kinsamanka/picnc/hardware/PICnc_Breadboard.png

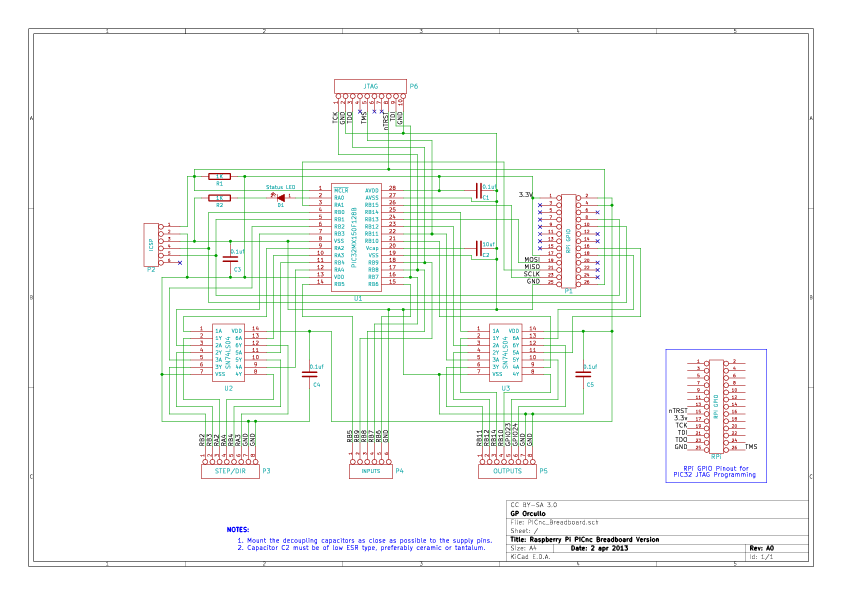
hardware/PICnc_Breadboard.png
