kinsamanka/picnc/hardware/PICnc_Jr.png

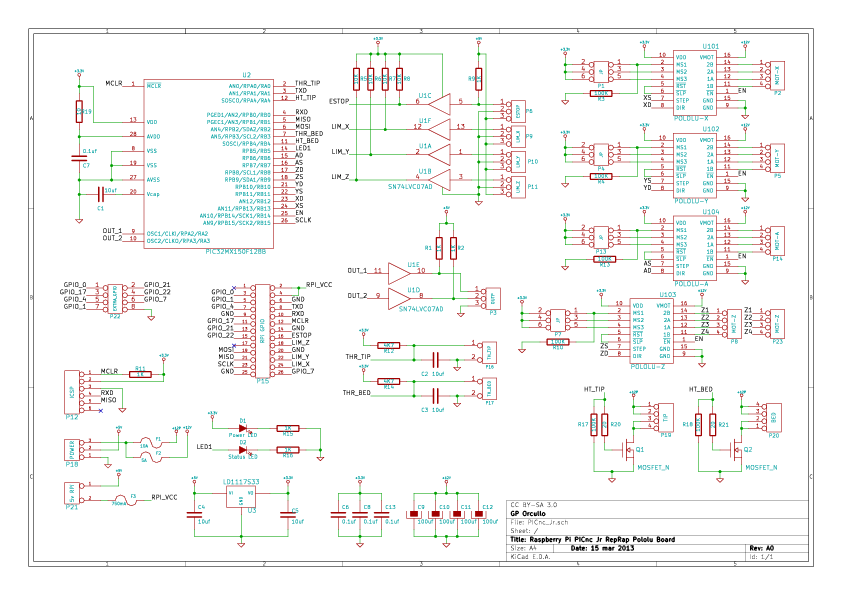
hardware/PICnc_Jr.png
