kinsamanka/picnc/hardware/PICnc_Jr_board.png

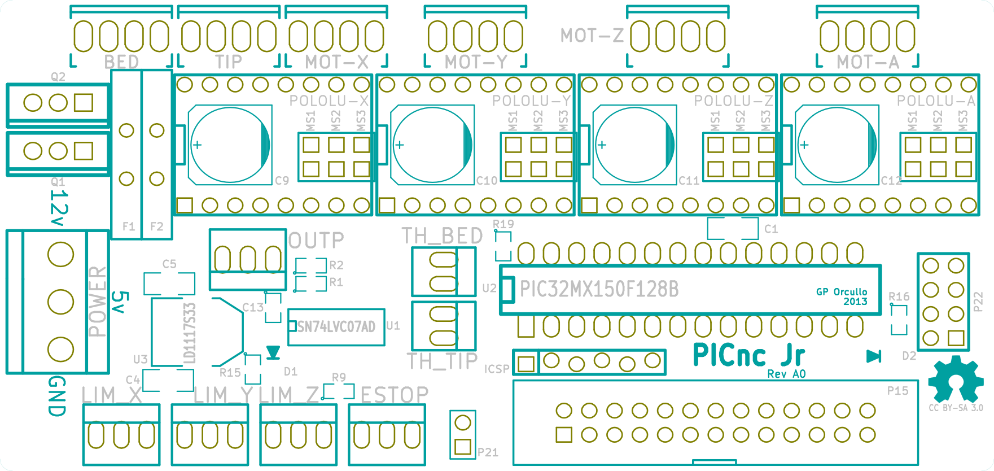
hardware/PICnc_Jr_board.png
