kinsamanka/picnc/hardware/PICnc_Breadboard.pdf

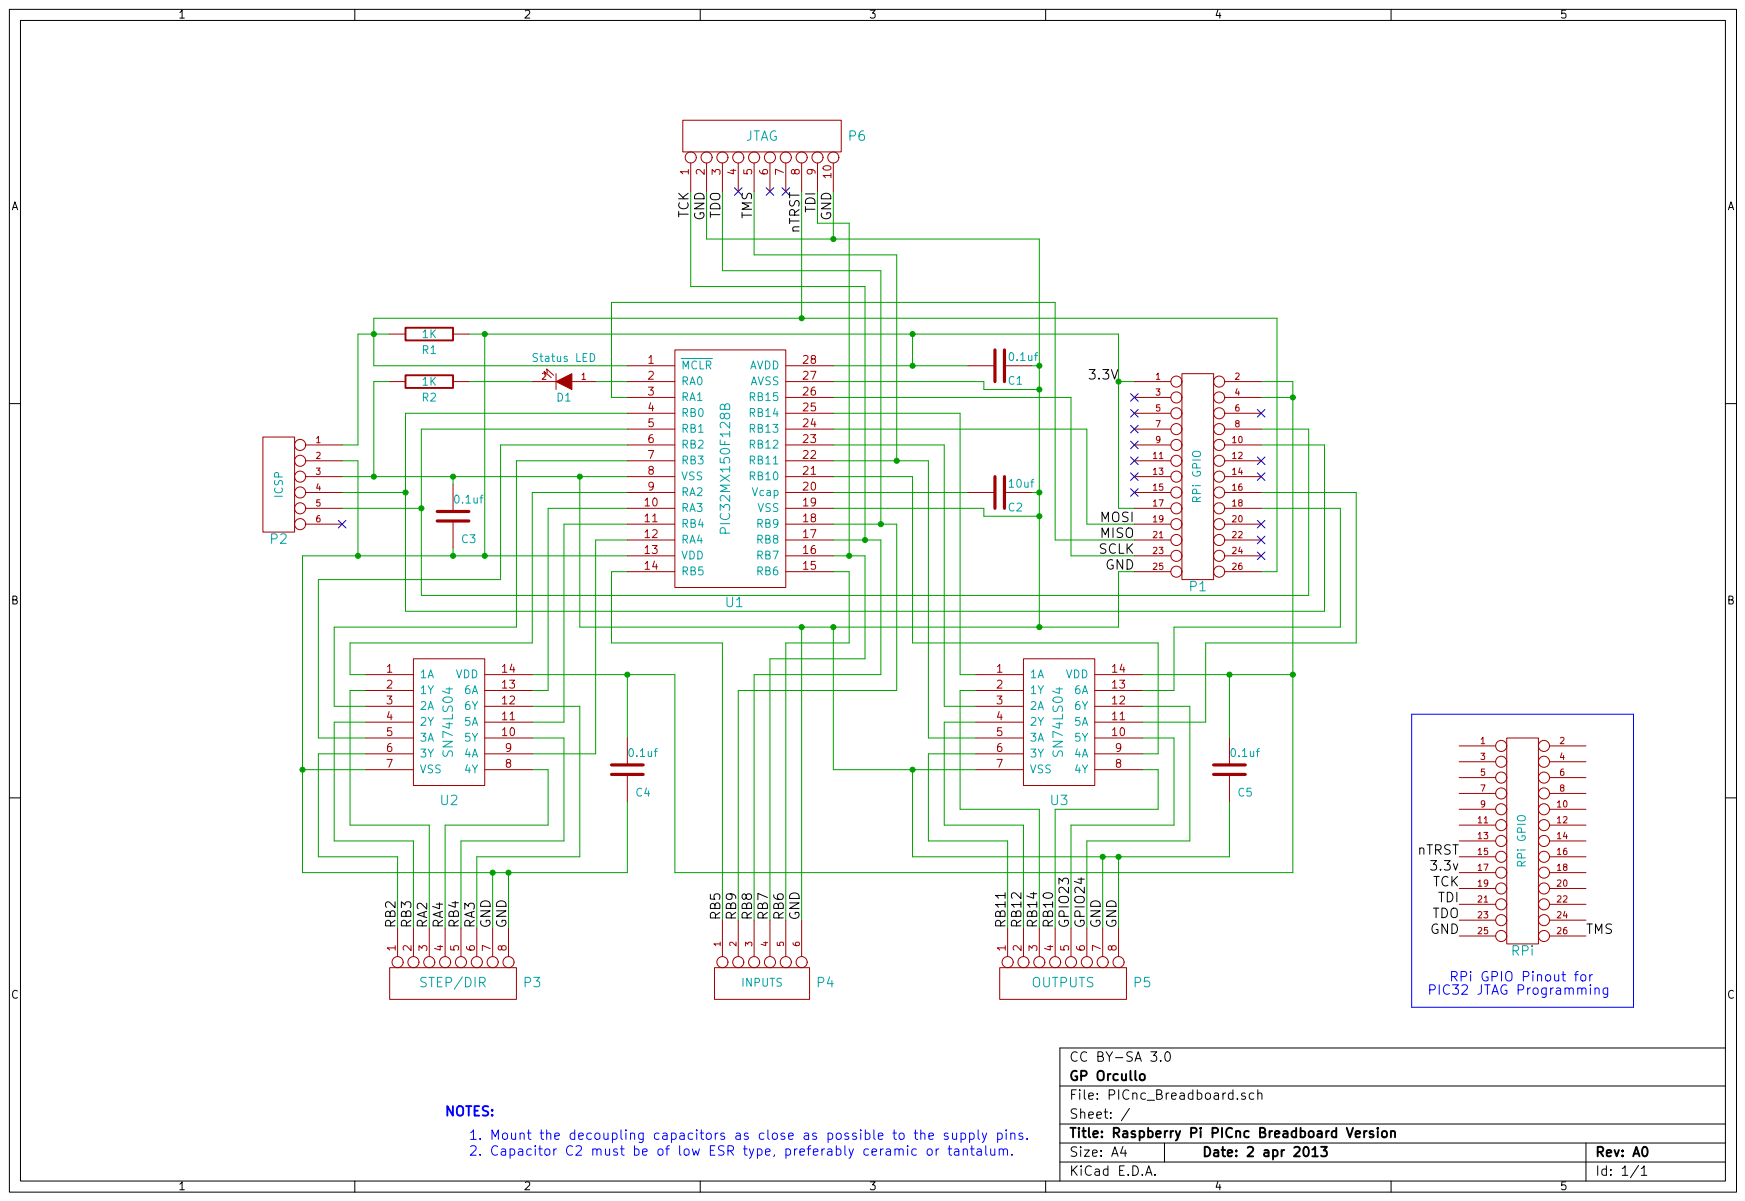
[picture p4: page 1]
