kinsamanka/picnc/hardware/PICnc_Jr.pdf

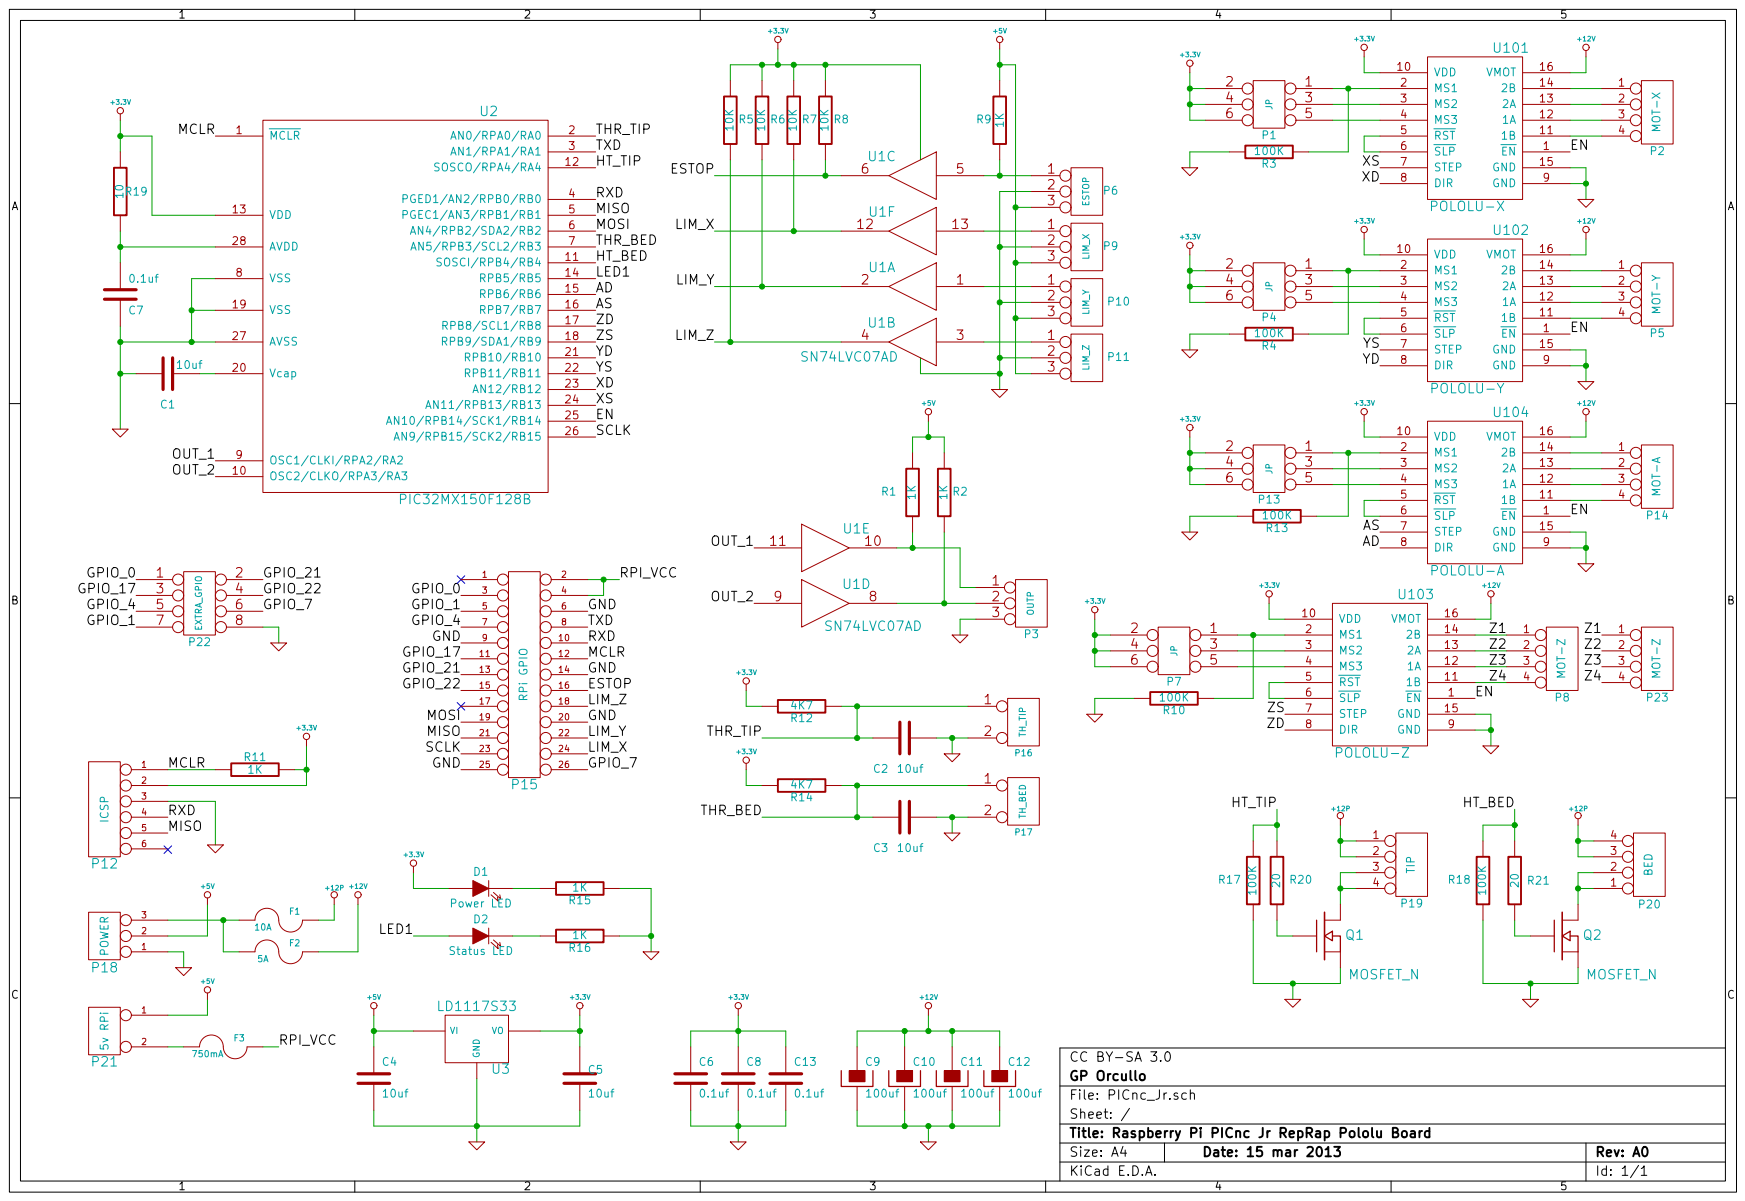
[picture p5: page 1]
