kinsamanka/picnc/hardware/PICnc.pdf

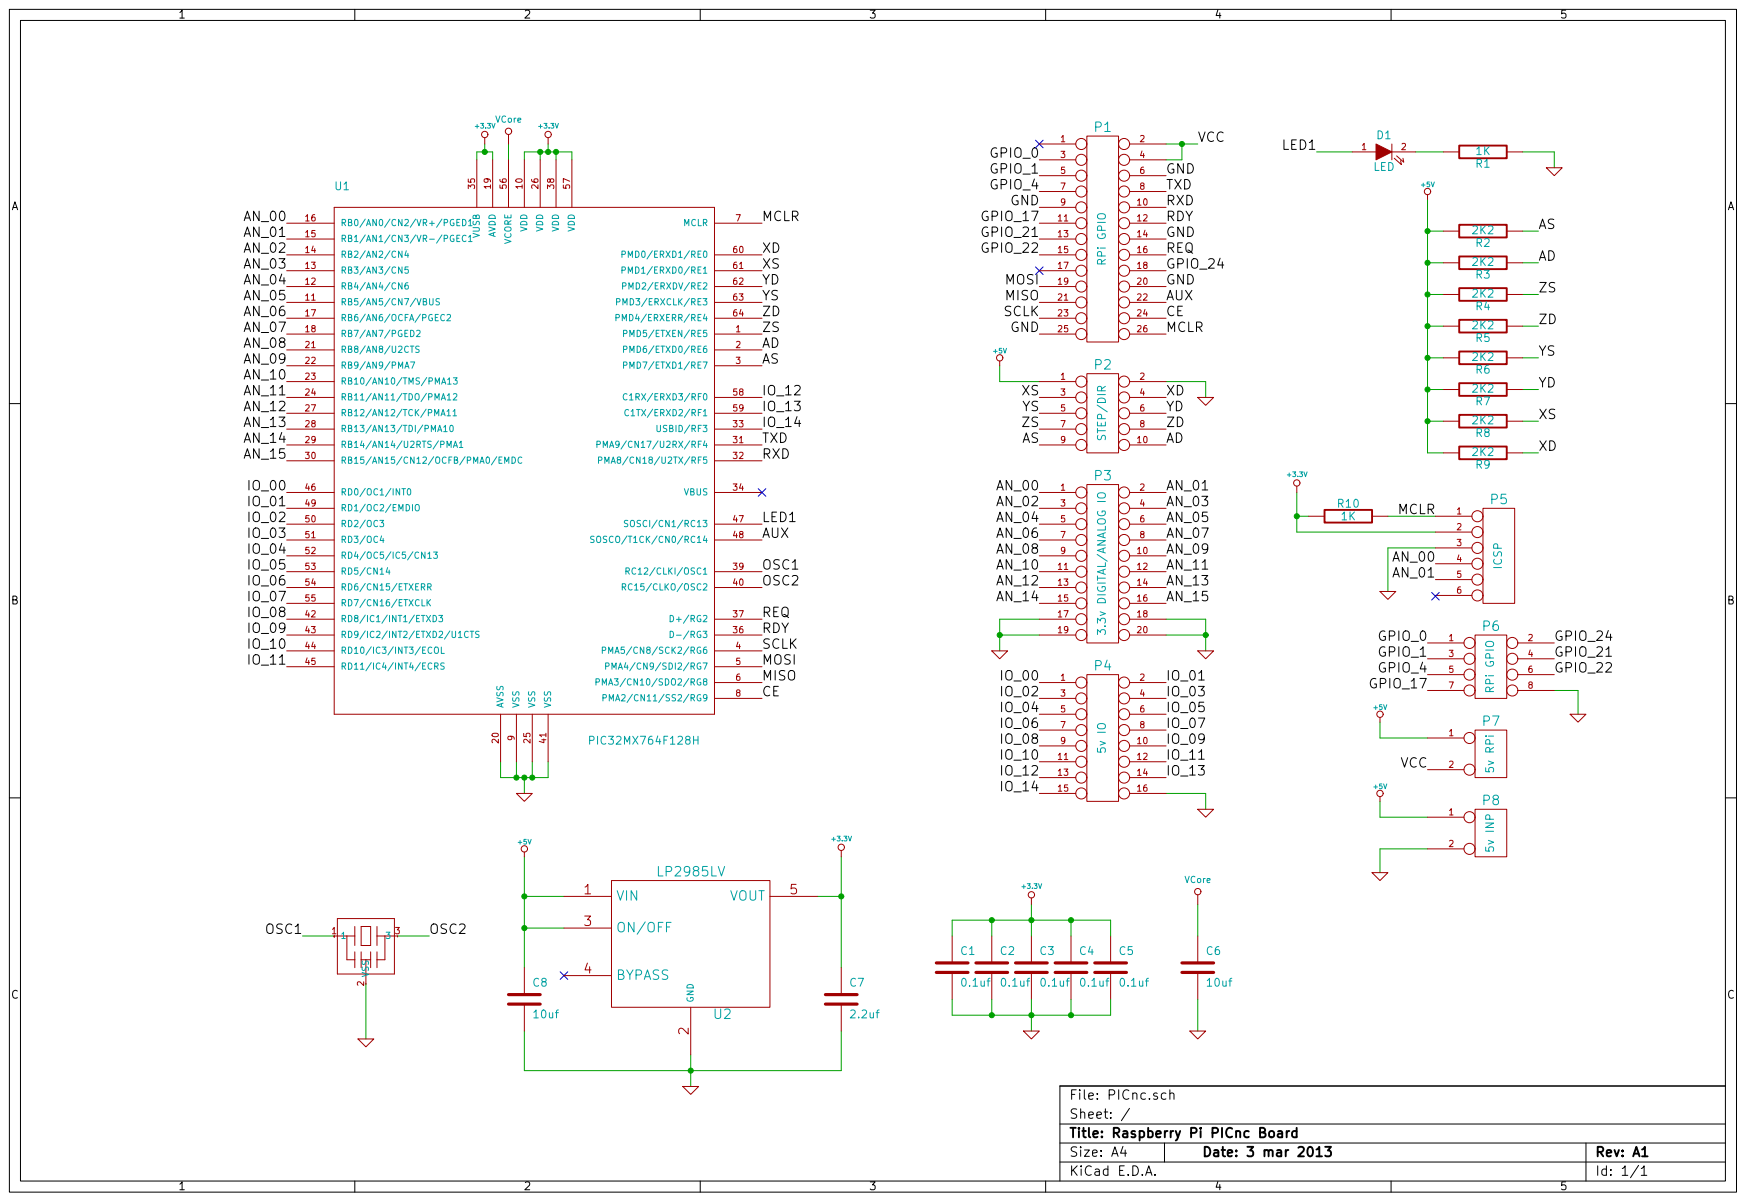
[picture p6: page 1]
