kinsamanka/picnc/hardware/PICnc_pcb.pdf

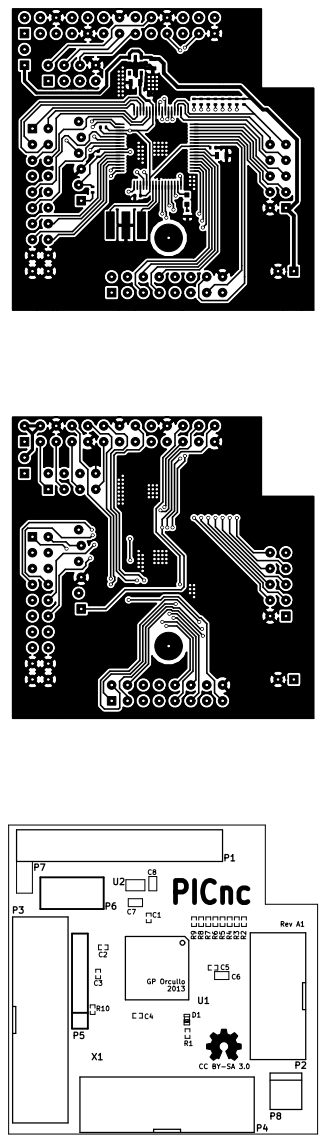
[picture p7: page 1]
