kinsamanka/picnc/hardware/PICnc.sch

## KiCad design hardware/PICnc.sch (2013-03-13)

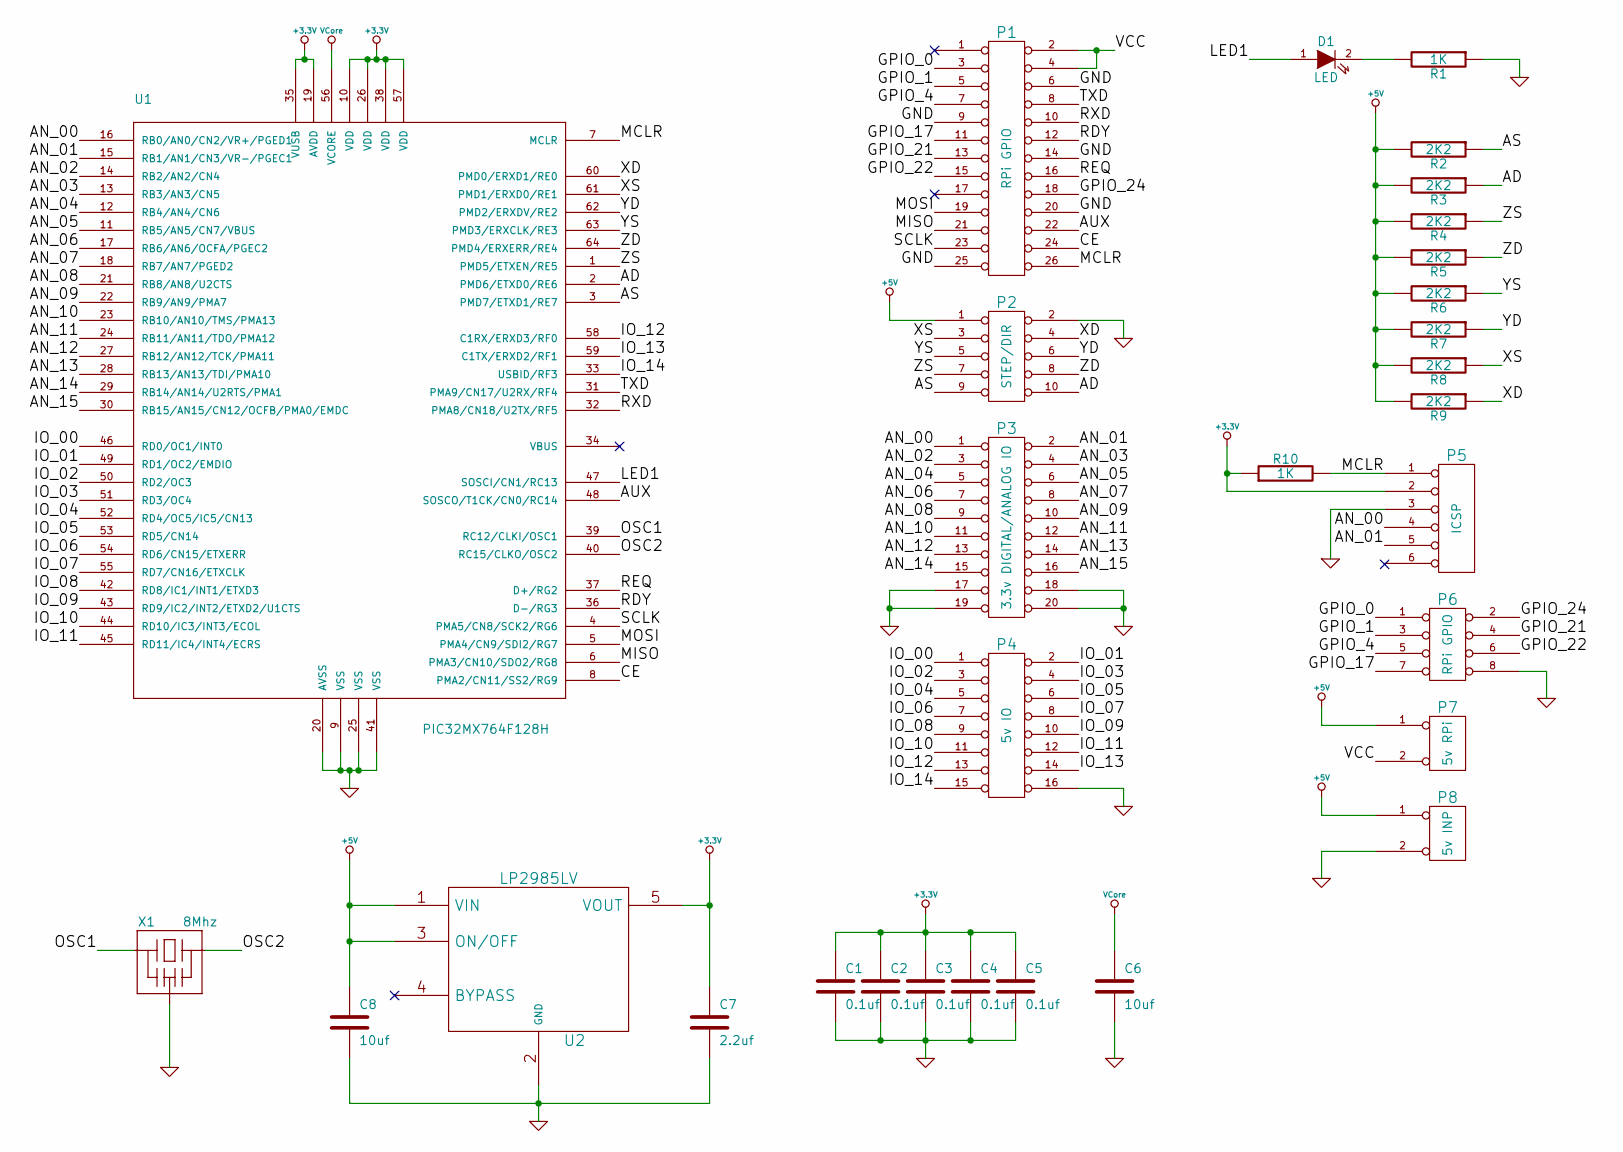
[picture p8: schematic PICnc.sch]

Parts:
C1, C2, C3, C4, C5: 0.1uf; SM0402
C6, C8: 10uf; SM0603
C7: 2.2uf; SM0603
D1: LED; LED-0603
P1, P6: RPi GPIO
P2: STEP/DIR
P3: 3.3v DIGITAL/ANALOG IO
P4: 5v IO
P5: ICSP
P7: 5v RPi
P8: 5v INP
R1, R10: 1K; SM0402
R2, R3, R4, R5, R6, R7, R8, R9: 2K2; SM0402
U1: PIC32MX764F128H; TQFP_64
U2: LP2985LV; SOT23-5
X1: 8Mhz; resonators-CSTCC

Connections:
+3.3V: C1.1, C2.1, C3.1, C4.1, C5.1, C7.1, P5.2, R10.1, U1.10 (VDD), U1.19 (AVDD), U1.26 (VDD), U1.35 (VUSB), U1.38 (VDD), U1.57 (VDD), U2.5 (VOUT)
+5V: C8.1, P2.1, P7.1, P8.1, R2.2, R3.2, R4.2, R5.2, R6.2, R7.2, R8.2, R9.2, U2.1 (VIN), U2.3 (ON/OFF)
AD: P2.10, R3.1, U1.2 (PMD6/ETXD0/RE6)
AN_00: P3.1, P5.4, U1.16 (RB0/AN0/CN2/VR+/PGED1)
AN_01: P3.2, P5.5, U1.15 (RB1/AN1/CN3/VR-/PGEC1)
AN_02: P3.3, U1.14 (RB2/AN2/CN4)
AN_03: P3.4, U1.13 (RB3/AN3/CN5)
AN_04: P3.5, U1.12 (RB4/AN4/CN6)
AN_05: P3.6, U1.11 (RB5/AN5/CN7/VBUS)
AN_06: P3.7, U1.17 (RB6/AN6/OCFA/PGEC2)
AN_07: P3.8, U1.18 (RB7/AN7/PGED2)
AN_08: P3.9, U1.21 (RB8/AN8/U2CTS)
AN_09: P3.10, U1.22 (RB9/AN9/PMA7)
AN_10: P3.11, U1.23 (RB10/AN10/TMS/PMA13)
AN_11: P3.12, U1.24 (RB11/AN11/TDO/PMA12)
AN_12: P3.13, U1.27 (RB12/AN12/TCK/PMA11)
AN_13: P3.14, U1.28 (RB13/AN13/TDI/PMA10)
AN_14: P3.15, U1.29 (RB14/AN14/U2RTS/PMA1)
AN_15: P3.16, U1.30 (RB15/AN15/CN12/OCFB/PMA0/EMDC)
AS: P2.9, R2.1, U1.3 (PMD7/ETXD1/RE7)
AUX: P1.22, U1.48 (SOSCO/T1CK/CN0/RC14)
CE: P1.24 (P20), U1.8 (PMA2/CN11/SS2/RG9)
GND: C1.2, C2.2, C3.2, C4.2, C5.2, C6.2, C7.2, C8.2, P1.6, P1.9, P1.14, P1.20, P1.25 (P24), P2.2, P3.17, P3.18, P3.19, P3.20, P4.16, P5.3, P6.8, P8.2, R1.1, U1.9 (VSS), U1.20 (AVSS), U1.25 (VSS), U1.41 (VSS), U2.2 (GND), X1.2 (VSS)
GPIO_0: P1.3, P6.1
GPIO_1: P1.5, P6.3
GPIO_4: P1.7, P6.5
GPIO_17: P1.11, P6.7
GPIO_21: P1.13, P6.4
GPIO_22: P1.15, P6.6
GPIO_24: P1.18, P6.2
IO_00: P4.1, U1.46 (RD0/OC1/INT0)
IO_01: P4.2, U1.49 (RD1/OC2/EMDIO)
IO_02: P4.3, U1.50 (RD2/OC3)
IO_03: P4.4, U1.51 (RD3/OC4)
IO_04: P4.5, U1.52 (RD4/OC5/IC5/CN13)
IO_05: P4.6, U1.53 (RD5/CN14)
IO_06: P4.7, U1.54 (RD6/CN15/ETXERR)
IO_07: P4.8, U1.55 (RD7/CN16/ETXCLK)
IO_08: P4.9, U1.42 (RD8/IC1/INT1/ETXD3)
IO_09: P4.10, U1.43 (RD9/IC2/INT2/ETXD2/U1CTS)
IO_10: P4.11, U1.44 (RD10/IC3/INT3/ECOL)
IO_11: P4.12, U1.45 (RD11/IC4/INT4/ECRS)
IO_12: P4.13, U1.58 (C1RX/ERXD3/RF0)
IO_13: P4.14, U1.59 (C1TX/ERXD2/RF1)
IO_14: P4.15, U1.33 (USBID/RF3)
LED1: D1.1 (A), U1.47 (SOSCI/CN1/RC13)
MCLR: P1.26 (P22), P5.1, R10.2, U1.7 (MCLR)
MISO: P1.21, U1.6 (PMA3/CN10/SDO2/RG8)
MOSI: P1.19, U1.5 (PMA4/CN9/SDI2/RG7)
unnamed: D1.2 (K), R1.2
OSC1: U1.39 (RC12/CLKI/OSC1), X1.1
OSC2: U1.40 (RC15/CLKO/OSC2), X1.3
RDY: P1.12, U1.36 (D-/RG3)
REQ: P1.16, U1.37 (D+/RG2)
RXD: P1.10, U1.32 (PMA8/CN18/U2TX/RF5)
SCLK: P1.23, U1.4 (PMA5/CN8/SCK2/RG6)
TXD: P1.8, U1.31 (PMA9/CN17/U2RX/RF4)
VCC: P1.2, P1.4, P7.2
VCore: C6.1, U1.56 (VCORE)
XD: P2.4, R9.1, U1.60 (PMD0/ERXD1/RE0)
XS: P2.3, R8.1, U1.61 (PMD1/ERXD0/RE1)
YD: P2.6, R7.1, U1.62 (PMD2/ERXDV/RE2)
YS: P2.5, R6.1, U1.63 (PMD3/ERXCLK/RE3)
ZD: P2.8, R5.1, U1.64 (PMD4/ERXERR/RE4)
ZS: P2.7, R4.1, U1.1 (PMD5/ETXEN/RE5)
