kinsamanka/picnc/hardware/PICnc_Breadboard.sch

## KiCad design hardware/PICnc_Breadboard.sch (2013-04-02)

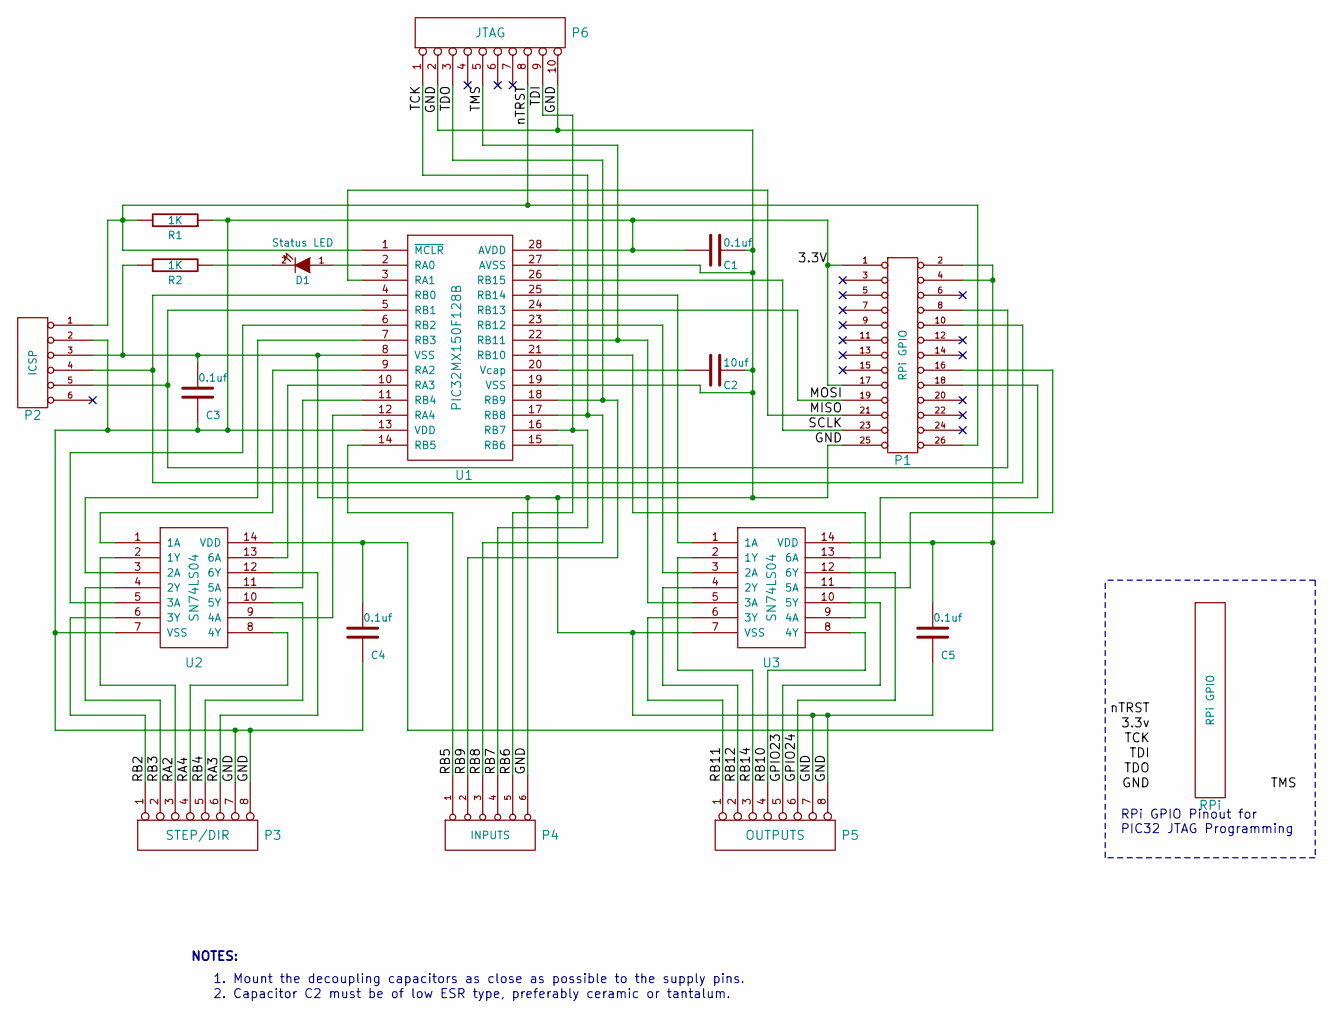
[picture p9: schematic PICnc_Breadboard.sch]

Parts:
C1, C3, C4, C5: 0.1uf; SM0805
C2: 10uf; SM1206
D1: Status LED; LED-0603
P1: RPi GPIO
P2: ICSP
P3: STEP/DIR
P4: INPUTS
P5: OUTPUTS
P6: JTAG
R1, R2: 1K; SM0805
RPi: RPi GPIO
U1: PIC32MX150F128B
U2, U3: SN74LS04

Connections:
3.3v: C1.1, C1.2, C2.1, C3.1, C3.2, C4.2, C5.2, P1.1, P1.17, P1.25 (P24), P2.2, P2.3, P3.7, P3.8, P4.6, P5.7, P5.8, P6.2, P6.10, R1.1, R2.1, U1.8 (VSS), U1.13 (VDD), U1.19 (VSS), U1.27 (AVSS), U1.28 (AVDD), U2.7 (VSS), U3.7 (VSS)
GPIO23: P5.5, U3.10 (5Y)
GPIO24: P5.6, U3.12 (6Y)
MISO: P1.21, U1.3 (RA1)
MOSI: P1.19, U1.24 (RB13)
unnamed: C2.2, U1.20 (Vcap)
unnamed: C4.1, C5.1, P1.2, P1.4, U2.14 (VDD), U3.14 (VDD)
unnamed: D1.1 (A), U1.2 (RA0)
unnamed: D1.2 (K), R2.2
unnamed: P1.8, P2.5, U1.5 (RB1)
unnamed: P1.10, P2.4, U1.4 (RB0)
unnamed: P1.16, U3.11 (5A)
unnamed: P1.18, U3.13 (6A)
unnamed: U1.6 (RB2), U2.5 (3A)
unnamed: U1.7 (RB3), U2.3 (2A)
unnamed: U1.9 (RA2), U2.1 (1A)
unnamed: U1.10 (RA3), U2.13 (6A)
unnamed: U1.11 (RB4), U2.11 (5A)
unnamed: U1.12 (RA4), U2.9 (4A)
unnamed: U1.21 (RB10), U3.9 (4A)
unnamed: U1.23 (RB12), U3.3 (2A)
unnamed: U1.25 (RB14), U3.1 (1A)
RA2: P3.3, U2.2 (1Y)
RA3: P3.6, U2.12 (6Y)
RA4: P3.4, U2.8 (4Y)
RB2: P3.1, U2.6 (3Y)
RB3: P3.2, U2.4 (2Y)
RB4: P3.5, U2.10 (5Y)
RB5: P4.1, U1.14 (RB5)
RB6: P4.5, U1.15 (RB6)
RB7: P4.4, P6.9, U1.16 (RB7)
RB8: P4.3, P6.1, U1.17 (RB8)
RB9: P4.2, P6.3, U1.18 (RB9)
RB10: P5.4, U3.8 (4Y)
RB11: P5.1, U3.6 (3Y)
RB12: P5.2, U3.4 (2Y)
RB14: P5.3, U3.2 (1Y)
SCLK: P1.23, U1.26 (RB15)
TMS: P6.5, U1.22 (RB11), U3.5 (3A)
nTRST: P1.26 (P22), P2.1, P6.8, R1.2, U1.1 (~MCLR)

Notes on the sheet:
2. Capacitor C2 must be of low ESR type, preferably ceramic or tantalum.
1. Mount the decoupling capacitors as close as possible to the supply pins.
NOTES:
RPi GPIO Pinout for PIC32 JTAG Programming
