kinsamanka/picnc/hardware/PICnc_Jr.sch

## KiCad design hardware/PICnc_Jr.sch (2013-03-15)

Schematic: PICnc_Jr.sch

Parts:
C1, C2, C3, C4, C5: 10uf; SM1206
C6, C7, C8, C13: 0.1uf; SM0805
C9, C10, C11, C12: 100uf
D1: Power LED; LED-0603
D2: Status LED; LED-0603
F1: 10A
F2: 5A
F3: 750mA
P1, P4, P7, P13: JP
P2: MOT-X
P3: OUTP
P5: MOT-Y
P6: ESTOP
P8, P23: MOT-Z
P9: LIM_X
P10: LIM_Y
P11: LIM_Z
P12: ICSP
P14: MOT-A
P15: RPi GPIO
P16: TH_TIP
P17: TH_BED
P18: POWER
P19: TIP
P20: BED
P21: 5v RPi
P22: EXTRA_GPIO
Q1, Q2: MOSFET_N
R1, R2, R9, R11, R15, R16: 1K; SM0805
R3, R4, R10, R13, R17, R18: 100K; SM0805
R5, R6, R7, R8: 10K; SM0805
R12, R14: 4K7; SM0805
R19: 10; SM0805
R20, R21: 20; SM0805
U1: SN74LVC07AD
U2: PIC32MX150F128B
U3: LD1117S33
U101: POLOLU-X
U102: POLOLU-Y
U103: POLOLU-Z
U104: POLOLU-A
