kinsamanka/picnc/configs/MF70/MF70.ini

# Generated by stepconf at Sun Jun 10 22:34:37 2012
# If you make changes to this file, they will be
# overwritten when you run stepconf again

[EMC]
MACHINE = MF70
DEBUG = 0

[DISPLAY]
DISPLAY = mini
EDITOR = gedit
POSITION_OFFSET = RELATIVE
POSITION_FEEDBACK = ACTUAL
MAX_FEED_OVERRIDE = 1.2
INTRO_GRAPHIC = linuxcnc.gif
INTRO_TIME = 5
PROGRAM_PREFIX = /home/ej/linuxcnc/nc_files
INCREMENTS = 5mm 1mm .5mm .1mm .05mm .01mm .005mm

[FILTER]
PROGRAM_EXTENSION = .png,.gif,.jpg Greyscale Depth Image
PROGRAM_EXTENSION = .py Python Script
png = image-to-gcode
gif = image-to-gcode
jpg = image-to-gcode
py = python

[TASK]
TASK = milltask
CYCLE_TIME = 0.010

[RS274NGC]
PARAMETER_FILE = linuxcnc.var

[EMCMOT]
EMCMOT = motmod
COMM_TIMEOUT = 1.0
COMM_WAIT = 0.010
BASE_PERIOD = 100000
SERVO_PERIOD = 1000000

[HAL]
HALFILE = MF70.hal

[TRAJ]
AXES = 3
COORDINATES = X Y Z
LINEAR_UNITS = mm
ANGULAR_UNITS = degree
CYCLE_TIME = 0.010
DEFAULT_VELOCITY = 0.44
MAX_LINEAR_VELOCITY = 4.40

[EMCIO]
EMCIO = io
CYCLE_TIME = 0.100
TOOL_TABLE = tool.tbl

[AXIS_0]
TYPE = LINEAR
HOME = 0.0
MAX_VELOCITY = 4.35416666667
MAX_ACCELERATION = 6.0
STEPGEN_MAXACCEL = 7.5
SCALE = 1200.0
FERROR = 1
MIN_FERROR = .25
MIN_LIMIT = -0.001
MAX_LIMIT = 150.0
HOME_OFFSET = 0.0

[AXIS_1]
TYPE = LINEAR
HOME = 0.0
MAX_VELOCITY = 3.95833333333
MAX_ACCELERATION = 6.0
STEPGEN_MAXACCEL = 7.5
SCALE = 1200.0
FERROR = 1
MIN_FERROR = .25
MIN_LIMIT = -0.001
MAX_LIMIT = 46.0
HOME_OFFSET = 0.0

[AXIS_2]
TYPE = LINEAR
HOME = 0.0
MAX_VELOCITY = 3.95833333333
MAX_ACCELERATION = 6.0
STEPGEN_MAXACCEL = 7.5
SCALE = 1200.0
FERROR = 1
MIN_FERROR = .25
MIN_LIMIT = -10.001
MAX_LIMIT = 70.0
HOME_OFFSET = 0.0
