kinsamanka/picnc/firmware/bootloader/BootLoader.c

/*********************************************************************
 *
 *                  PIC32 Boot Loader
 *
 *********************************************************************
 * FileName:        Bootloader.c
 * Dependencies:
 * Processor:       PIC32
 *
 * Compiler:        MPLAB C32
 *                  MPLAB IDE
 * Company:         Microchip Technology, Inc.
 *
 * Software License Agreement
 *
 * The software supplied herewith by Microchip Technology Incorporated
 * (the �Company�) for its PIC32 Microcontroller is intended
 * and supplied to you, the Company�s customer, for use solely and
 * exclusively on Microchip PIC32 Microcontroller products.
 * The software is owned by the Company and/or its supplier, and is
 * protected under applicable copyright laws. All rights are reserved.
 * Any use in violation of the foregoing restrictions may subject the
 * user to criminal sanctions under applicable laws, as well as to
 * civil liability for the breach of the terms and conditions of this
 * license.
 *
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
 *
 * $Id:  $
 * $Name: $
 *
 **********************************************************************/
#include <stdlib.h>
#include <plib.h>
#include "HardwareProfile.h"
#include "BootLoader.h"
#include "Framework.h"

#pragma config DEBUG	= OFF		// Background Debugger disabled
#pragma config FPLLMUL	= MUL_20	// PLL Multiplier: Multiply by 20
#pragma config FPLLIDIV	= DIV_2		// PLL Input Divider:  Divide by 2
#pragma config FPLLODIV	= DIV_1		// PLL Output Divider: Divide by 1

#pragma config FWDTEN	= OFF		// WD timer: OFF
#pragma config POSCMOD	= XT		// Primary Oscillator Mode: High Speed xtal
#pragma config FNOSC	= PRIPLL	// Oscillator Selection: Primary oscillator  w/ PLL
#pragma config FPBDIV	= DIV_1		// Peripheral Bus Clock: Divide by 1
#pragma config BWP	= ON		// Boot write protect
#pragma config FSOSCEN	= OFF		// Secondary Oscillator
#pragma config ICESEL	= ICS_PGx2	// ICE pins configured on PGx2, Boot write protect OFF.

#define SWITCH_PRESSED 0

BOOL CheckTrigger(void);
void JumpToApp(void);
BOOL ValidAppPresent(void);

/********************************************************************
* Function: 	main()
*
* Precondition:
*
* Input: 		None.
*
* Output:		None.
*
* Side Effects:	None.
*
* Overview: 	Main entry function. If there is a trigger or
*				if there is no valid application, the device
*				stays in firmware upgrade mode.
*
*
* Note:		 	None.
********************************************************************/
INT main(void)
{
	UINT pbClk;

	// Setup configuration
	pbClk = SYSTEMConfig(SYS_FREQ, SYS_CFG_WAIT_STATES | SYS_CFG_PCACHE);

	InitLED();

	// Enter firmware upgrade mode if there is a trigger or if the application is not valid
	if (CheckTrigger() || !ValidAppPresent()) {
		/* wait until RX pin is released */
		while (ReadSwitchStatus() == 0);

		// Initialize the transport layer - UART/USB/Ethernet
		TRANS_LAYER_Init(pbClk);

		while (!FRAMEWORK_ExitFirmwareUpgradeMode()) { // Be in loop till framework recieves "run application" command from PC
			// Enter firmware upgrade mode.
			// Be in loop, looking for commands from PC
			TRANS_LAYER_Task(); // Run Transport layer tasks
			FRAMEWORK_FrameWorkTask(); // Run frame work related tasks (Handling Rx frame, process frame and so on)
			// Blink LED (Indicates the user that bootloader is running).
			BlinkLED();
		}
		// Close trasnport layer.
		TRANS_LAYER_Close();
	}

	// No trigger + valid application = run application.
	JumpToApp();

	return 0;
}


/********************************************************************
* Function: 	CheckTrigger()
*
* Precondition:
*
* Input: 		None.
*
* Output:		TRUE: If triggered
				FALSE: No trigger
*
* Side Effects:	None.
*
* Overview: 	Checks if there is a trigger to enter
				firmware upgrade mode.
*
*
* Note:		 	None.
********************************************************************/
BOOL  CheckTrigger(void)
{
	UINT SwitchStatus;
	SwitchStatus = ReadSwitchStatus();
	if (SwitchStatus == SWITCH_PRESSED) {
		// Switch is pressed
		return TRUE;
	} else {
		// Switch is not pressed.
		return FALSE;
	}
}


/********************************************************************
* Function: 	JumpToApp()
*
* Precondition:
*
* Input: 		None.
*
* Output:
*
* Side Effects:	No return from here.
*
* Overview: 	Jumps to application.
*
*
* Note:		 	None.
********************************************************************/
void JumpToApp(void)
{
	void (*fptr)(void);
	fptr = (void ( *)(void))USER_APP_RESET_ADDRESS;
	fptr();
}


/********************************************************************
* Function: 	ValidAppPresent()
*
* Precondition:
*
* Input: 		None.
*
* Output:		TRUE: If application is valid.
*
* Side Effects:	None.
*
* Overview: 	Logic: Check application vector has
				some value other than "0xFFFFFFFF"
*
*
* Note:		 	None.
********************************************************************/
BOOL ValidAppPresent(void)
{
	DWORD *AppPtr;
	AppPtr = (DWORD *)USER_APP_RESET_ADDRESS;
	if (*AppPtr == 0xFFFFFFFF) {
		return FALSE;
	} else {
		return TRUE;
	}
}


/*********************End of File************************************/
