kinsamanka/picnc/firmware/bootloader/BootLoader.h

// Copyright (c) 2002-2010,  Microchip Technology Inc.
//
// Microchip licenses this software to you solely for use with Microchip
// products.  The software is owned by Microchip and its licensors, and
// is protected under applicable copyright laws.  All rights reserved.
//
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
// To the fullest extent allowed by law, Microchip and its licensors
// liability shall not exceed the amount of fees, if any, that you
// have paid directly to Microchip to use this software.
//
// MICROCHIP PROVIDES THIS SOFTWARE CONDITIONALLY UPON YOUR ACCEPTANCE
// OF THESE TERMS.
#ifndef __BOOTLOADER_H__
#define __BOOTLOADER_H__

#define PROGRAM_FLASH_END_ADRESS (0x9D000000+BMXPFMSZ-1)
#define MAJOR_VERSION 1
#define MINOR_VERSION 0

#define APP_FLASH_BASE_ADDRESS 	0x9D000000 
#define APP_FLASH_END_ADDRESS   PROGRAM_FLASH_END_ADRESS
#define USER_APP_RESET_ADDRESS 	(0x9D000000 + 0x1000)

#include "Uart.h"
#endif
