kinsamanka/picnc/firmware/bootloader/NVMem.c

/*********************************************************************
 *
 *                  PIC32 Boot Loader
 *
 *********************************************************************
 * FileName:        NVMem.c
 * Dependencies:
 * Processor:       PIC32
 *
 * Compiler:        MPLAB C32
 *                  MPLAB IDE
 * Company:         Microchip Technology, Inc.
 *
 * Software License Agreement
 *
 * The software supplied herewith by Microchip Technology Incorporated
 * (the “Company”) for its PIC32 Microcontroller is intended
 * and supplied to you, the Company’s customer, for use solely and
 * exclusively on Microchip PIC32 Microcontroller products.
 * The software is owned by the Company and/or its supplier, and is
 * protected under applicable copyright laws. All rights are reserved.
 * Any use in violation of the foregoing restrictions may subject the
 * user to criminal sanctions under applicable laws, as well as to
 * civil liability for the breach of the terms and conditions of this
 * license.
 *
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
 *
 * $Id:  $
 * $Name: $
 *
 **********************************************************************/
#include <plib.h>
#include "HardwareProfile.h"
#include "BootLoader.h"
#include "Framework.h"
#include "NVMem.h"


const UINT countPerMicroSec = ((SYS_FREQ/1000000)/2);
#define NVMemIsError()    (NVMCON & (_NVMCON_WRERR_MASK | _NVMCON_LVDERR_MASK))

/********************************************************************
* Function: 	delay_us()
*
* Precondition: 
*
* Input: 		Micro second
*
* Output:		None.
*
* Side Effects:	Uses Core timer. This may affect other functions using core timers.
				For example, core timer interrupt may not work, or may loose precision.				
*
* Overview:     Provides Delay in microsecond.
*
*			
* Note:		 	None.
********************************************************************/
void delay_us(UINT us)
{
   
    UINT targetCount;  
    UINT bakupCount; 

    // Assert "us" not zero. This must be caught during debug phase.
    //ASSERT(us!=0);
    // backup current count of the core timer.
    bakupCount = ReadCoreTimer();
    // Core timer increments every 2 sys clock cycles.
    // Calculate the counts required to complete "us". 
    targetCount = countPerMicroSec * us;      
    // Restart core timer.
    WriteCoreTimer(0);    
    // Wait till core timer completes the count.    
    while(ReadCoreTimer() < targetCount);
    
    // Restore count back.
    WriteCoreTimer(bakupCount + targetCount);       	
   
}  



/********************************************************************
* Function: 	NVMemOperation()
*
* Precondition: 
*
* Input: 		NV operation
*
* Output:		NV eror
*
* Side Effects:	This function must generate MIPS32 code only and 
				hence the attribute (nomips16)
*
* Overview:     Performs reuested operation.
*
*			
* Note:		 	None.
********************************************************************/
UINT __attribute__((nomips16)) NVMemOperation(UINT nvmop)
{
    int	int_status;
    int	susp;

    // Disable DMA & Disable Interrupts
	#ifdef _DMAC
	int_status = INTDisableInterrupts();
	susp = DmaSuspend();
	#else
	int_status = INTDisableInterrupts(); 
	#endif	// _DMAC

    // Enable Flash Write/Erase Operations
    NVMCON = NVMCON_WREN | nvmop;
    // Data sheet prescribes 6us delay for LVD to become stable.
    // To be on the safer side, we shall set 7us delay.
    delay_us(7);

    NVMKEY 		= 0xAA996655;
    NVMKEY 		= 0x556699AA;
    NVMCONSET 	= NVMCON_WR;

    // Wait for WR bit to clear
    while(NVMCON & NVMCON_WR);
    
    // Disable Flash Write/Erase operations
    NVMCONCLR = NVMCON_WREN;  


	// Enable DMA & Enable Interrupts
	#ifdef _DMAC
	DmaResume(susp);
	INTRestoreInterrupts(int_status);
	#else
	INTRestoreInterrupts(int_status);
	#endif // _DMAC

	// Return Error Status
    return(NVMemIsError());
}


/*********************************************************************
 * Function:        unsigned int NVMErasePage(void* address)
 *
 * Description:     A page erase will erase a single page of program flash,
 *                  which equates to 1k instructions (4KBytes). The page to
 *                  be erased is selected using NVMADDR. The lower bytes of
 *                  the address given by NVMADDR are ignored in page selection.
 *
 * PreCondition:    None
 *
 * Inputs:          address:  Destination page address to Erase.
 *
 * Output:          '0' if operation completed successfully.
 *
 * Example:         NVMemErasePage((void*) 0xBD000000)
 ********************************************************************/
UINT NVMemErasePage(void* address)
{
    UINT res;

    // Convert Address to Physical Address
	NVMADDR = KVA_TO_PA((unsigned int)address);

	// Unlock and Erase Page
	res = NVMemOperation(NVMOP_PAGE_ERASE);

	// Return WRERR state.
	return res;

}


/*********************************************************************
 * Function:        unsigned int NVMWriteWord(void* address, unsigned int data)
 *
 * Description:     The smallest block of data that can be programmed in
 *                  a single operation is 1 instruction word (4 Bytes).  The word at
 *                  the location pointed to by NVMADDR is programmed.
 *
 * PreCondition:    None
 *
 * Inputs:          address:   Destination address to write.
 *                  data:      Word to write.
 *
 * Output:          '0' if operation completed successfully.
 *
 * Example:         NVMWriteWord((void*) 0xBD000000, 0x12345678)
 ********************************************************************/
UINT NVMemWriteWord(void* address, UINT data)
{
    UINT res;

    NVMADDR = KVA_TO_PA((unsigned int)address);

    // Load data into NVMDATA register
    NVMDATA = data;

    // Unlock and Write Word
    res = NVMemOperation(NVMOP_WORD_PGM);

	return res;
}




/*********************************************************************
 * Function:        unsigned int NVMWriteRow(void* address, void* data)
 *
 * Description:     The largest block of data that can be programmed in
 *                  a single operation is 1 row 128 instructions (512 Bytes).  The row at
 *                  the location pointed to by NVMADDR is programmed with the data buffer
 *                  pointed to by NVMSRCADDR.
 *
 * PreCondition:    The row of data must be pre-loaded into a buffer in RAM.
 *
 * Inputs:          address:  Destination Row address to write.
 *                  data:  Location of data to write.
 *
 * Output:          '0' if operation completed successfully.
 *
 * Example:         NVMWriteRow((void*) 0xBD000000, (void*) 0xA0000000)
 ********************************************************************/
UINT NVMemWriteRow(void* address, void* data)
{
    unsigned int res;

    // Set NVMADDR to Address of row t program
    NVMADDR = KVA_TO_PA((unsigned int)address);

    // Set NVMSRCADDR to the SRAM data buffer Address
    NVMSRCADDR = KVA_TO_PA((unsigned int)data);

    // Unlock and Write Row
    res = NVMemOperation(NVMOP_ROW_PGM);

    return res;
}



/*********************************************************************
 * Function:        unsigned int NVMClearError(void)
 *
 * Description:		Clears the NVMCON error flag.
 *
 * PreCondition:    None
 *
 * Inputs:			None
 *
 * Output:          '0' if operation completed successfully.
 *
 * Example:			NMVClearError()
 ********************************************************************/
UINT NVMemClearError(void)
{
    unsigned int res;

    res = NVMemOperation(NVMOP_NOP);

    return res;
}





/***********************End of File*************************************************************/
