kinsamanka/picnc/(commit log)

2013-02-17 Initial upload
    [PICnc.brd, PICnc.sch]
2013-02-18 minor schematic rename
    [PICnc.sch]
2013-02-18 firmware change for board rev A0
2013-02-18 fixed ICSP pinout
    [PICnc.brd, PICnc.sch]
2013-02-18 update HAL for board rev A0
2013-02-18 Added simple SPI HAL driver
2013-02-21 Added schematics in PDF format
2013-03-01 added AN1388 UART bootlader
2013-03-02 Rev A1 board - mounting hole + moved all components to top layer
    [PICnc.brd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]
2013-03-03 added BOM
    [PICnc.brd, PICnc.sch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]
2013-03-03 Board version A1 - replaced pull-up resistors
    [PICnc.sch]
2013-03-13 schematic cleanup
    [PICnc.sch]
2013-03-13 Added PICnc Jr RepRap Pololu Board
    [PICnc_Jr.brd, PICnc_Jr.sch]
2013-03-13 added pdf schematic
2013-03-15 added polyfuses, changed mosfet package, added gerber files
    [PICnc_Jr.brd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]
2013-03-15 added schematic output
2013-03-15 added board
2013-03-23 fixed mounting hole issue
    [PICnc.brd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]
2013-03-29 enabled pull-ups and reduced spi timeout
2013-04-02 enabled watchdog and increased LED blink rate
2013-04-02 added PICnc breadboard version
    [PICnc_Breadboard.sch]
2013-04-02 new HAL drivers
2013-04-03 pin RG3 is input only, swapped with AUX
    [hardware.h, main.c]
2013-04-03 reduced SPI speed and SPI buffer size for DIP PIC32
2013-04-03 fixed pin init
2013-04-03 disabled SPI slave select
2013-04-04 added MF70 config
    [MF70.hal]
2013-05-13 - fixed intermittent missing dir signal. - set step pulse width to a fixed value
    [stepgen.c]
