kinsamanka/picnc/(notices)

Notices in the files:
firmware/PICnc Breadboard/main.c:
This program is free software; you can redistribute it and/or modify
it under the terms of the GNU General Public License as published by
the Free Software Foundation; either version 3 of the License, or
(at your option) any later version.
HAL/hal_picnc.h:
the Free Software Foundation; either version 2 of the License, or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
hardware/PICnc_Jr.sch:
CC BY-SA 3.0
